naguirre/mds-builder/mds-hardware/README.md

# mds-hardware

KiCad sources and fabrication outputs for a small network audio player board built around an Allwinner F1C200s SoC, an ESP32-C3 for Wi-Fi, NAND flash storage, an EA3036 power management IC, and an audio DAC daughter board.

The repository contains two KiCad projects:
- [network_player/](network_player/) — the main board
- [dac/](dac/) — the audio DAC daughter board

## Versions

| Version | Date | Status | Schematic | PCB | Gerbers |
|---|---|---|---|-----|---|
| v1 | 2024-01-15 | Sent to JLCPCB, had routing issues | [PDF](../doc/static/hardware/v1/schematic.pdf) | [PDF](../doc/static/hardware/v1/pcb.pdf) | [ZIP](../doc/static/hardware/v1/gerbers.zip) |
| v1.1 | 2024-06-02 | Sent to JLCPCB, fixes routing issues of v1 | [PDF](../doc/static/hardware/v1.1/schematic.pdf) | [PDF](../doc/static/hardware/v1.1/pcb.pdf) | [ZIP](../doc/static/hardware/v1.1/gerbers.zip) |
| v2 | 2024-10-17 | Full redesign on Allwinner T113-s3, never produced | [PDF](../doc/static/hardware/v2/schematic.pdf) | [PDF](../doc/static/hardware/v2/pcb.pdf) | [ZIP](../doc/static/hardware/v2/gerbers.zip) |

See also the rendered [Board design](../doc/content/hardware/design.md) page in the main documentation.

References on GitHub: v1 is at commit [`c1560a5`](../../commit/c1560a5), v1.1 is the [`v1.1`](../../tree/v1.1) tag, v2 lives on the [`network_player_v2`](../../tree/network_player_v2) branch. The [`v1_jlcpcb`](../../tree/v1_jlcpcb) tag points to the JLCPCB return files for v1.

## Latest produced version: v1.1

v1.1 is the version that was actually fabricated and assembled by JLCPCB. Compared to v1, it brings the following changes (see commit [`47ae173`](../../commit/47ae173)):

- Removed the discrete transistors used for ESP32 boot/reset, driven directly from F1C200s GPIOs instead
- EA3036 enable pin tied to 3.3 V
- Added a RST button that pulls the MISO line to ground to disable booting from flash
- ESP32 moved to SPI1; SPI0 is now shared between the NAND flash and the RPi connector

### Schematic

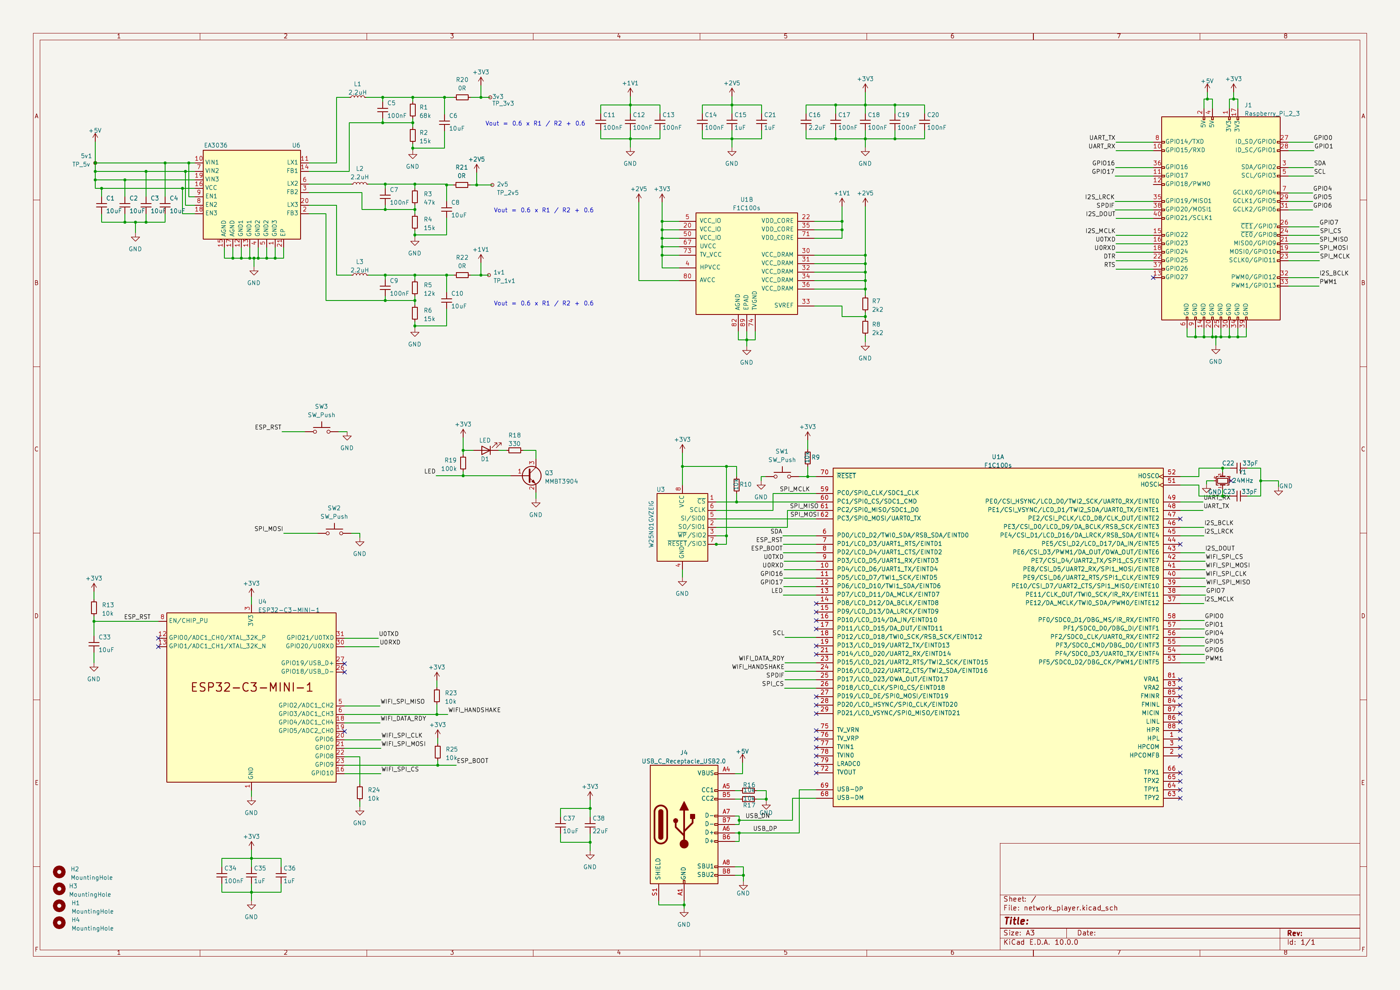
[picture p1: doc/static/hardware/v1.1/schematic.png]
v1.1 schematic


## License

The hardware design (KiCad sources, schematics, PCB layouts and gerbers) is released under the **CERN Open Hardware Licence Version 2 — Permissive** (CERN-OHL-P v2). See [LICENSE](LICENSE).

Copyright (c) 2026 Nicolas Aguirre.
