naguirre/mds-builder/doc/content/hardware/design.md

+++
title = "Board design"
description = "KiCad sources, schematics, PCB versions and fabrication outputs"
weight = 3
+++

# Board design

The board has been designed with [KiCad](https://www.kicad.org/). Both KiCad 7.x and 8.x have been used during the development.

The KiCad sources live in this repository under `mds-hardware/`, split into two projects:

- `mds-hardware/network_player/` — the main board
- `mds-hardware/dac/` — the audio DAC daughter board

## Schematics

A rendered SVG of the schematics is included for quick reference:

{{ img(path="images/network_player.svg", alt="Schematics") }}

## Versions

<table>
  <thead>
    <tr><th>Version</th><th>Date</th><th>Status</th><th>Schematic</th><th>PCB</th><th>Gerbers</th></tr>
  </thead>
  <tbody>
    <tr>
      <td>v1</td><td>2024-01-15</td><td>Sent to JLCPCB, had routing issues</td>
      <td>{{ dl(path="hardware/v1/schematic.pdf", text="PDF") }}</td>
      <td>{{ dl(path="hardware/v1/pcb.pdf", text="PDF") }}</td>
      <td>{{ dl(path="hardware/v1/gerbers.zip", text="ZIP") }}</td>
    </tr>
    <tr>
      <td>v1.1</td><td>2024-06-02</td><td>Sent to JLCPCB, fixes routing issues of v1</td>
      <td>{{ dl(path="hardware/v1.1/schematic.pdf", text="PDF") }}</td>
      <td>{{ dl(path="hardware/v1.1/pcb.pdf", text="PDF") }}</td>
      <td>{{ dl(path="hardware/v1.1/gerbers.zip", text="ZIP") }}</td>
    </tr>
    <tr>
      <td>v2</td><td>2024-10-17</td><td>Full redesign on Allwinner T113-s3, never produced</td>
      <td>{{ dl(path="hardware/v2/schematic.pdf", text="PDF") }}</td>
      <td>{{ dl(path="hardware/v2/pcb.pdf", text="PDF") }}</td>
      <td>{{ dl(path="hardware/v2/gerbers.zip", text="ZIP") }}</td>
    </tr>
  </tbody>
</table>

## Latest produced version: v1.1

v1.1 is the version that was actually fabricated and assembled by JLCPCB. Compared to v1, it brings the following changes:

- Removed the discrete transistors used for ESP32 boot/reset, driven directly from F1C200s GPIOs instead
- EA3036 enable pin tied to 3.3 V
- Added a RST button that pulls the MISO line to ground to disable booting from flash
- ESP32 moved to SPI1; SPI0 is now shared between the NAND flash and the RPi connector

{{ img(path="hardware/v1.1/schematic.png", alt="v1.1 schematic") }}

### Assembled boards

The v1.1 board as assembled by JLCPCB:

{{ img(path="images/v1.1_top.jpeg", alt="Network player v1.1, top side") }}

{{ img(path="images/v1.1_bottom.jpeg", alt="Network player v1.1, bottom side") }}

For reference, the earlier v1 board:

{{ img(path="images/v1.0_top.jpeg", alt="Network player v1, top side") }}

{{ img(path="images/v1.0_bottom.jpeg", alt="Network player v1, bottom side") }}
