naguirre/mds-builder/doc/content/development/_index.md

+++
title = "Development"
description = "Day-to-day development tasks on the firmware"
sort_by = "weight"
weight = 5
template = "section.html"
page_template = "page.html"
+++

# Development

This section collects the things you reach for during normal development cycles: rebuilding the kernel or U-Boot, pushing a new module to the running board, debugging over serial.

## Sections

- [Kernel development](@/development/kernel.md) — iterate on Linux + custom drivers
- [U-Boot development](@/development/uboot.md) — iterate on the bootloader and DTS
- [Debugging](@/development/debugging.md) — console access, USB gadget, common issues
- [ESP-Hosted firmware](@/development/esp-hosted.md) — rebuild the ESP32-C3 firmware and bring up the Wi-Fi link
