naguirre/mds-builder/mds-hardware/network_player/network_player.pdf

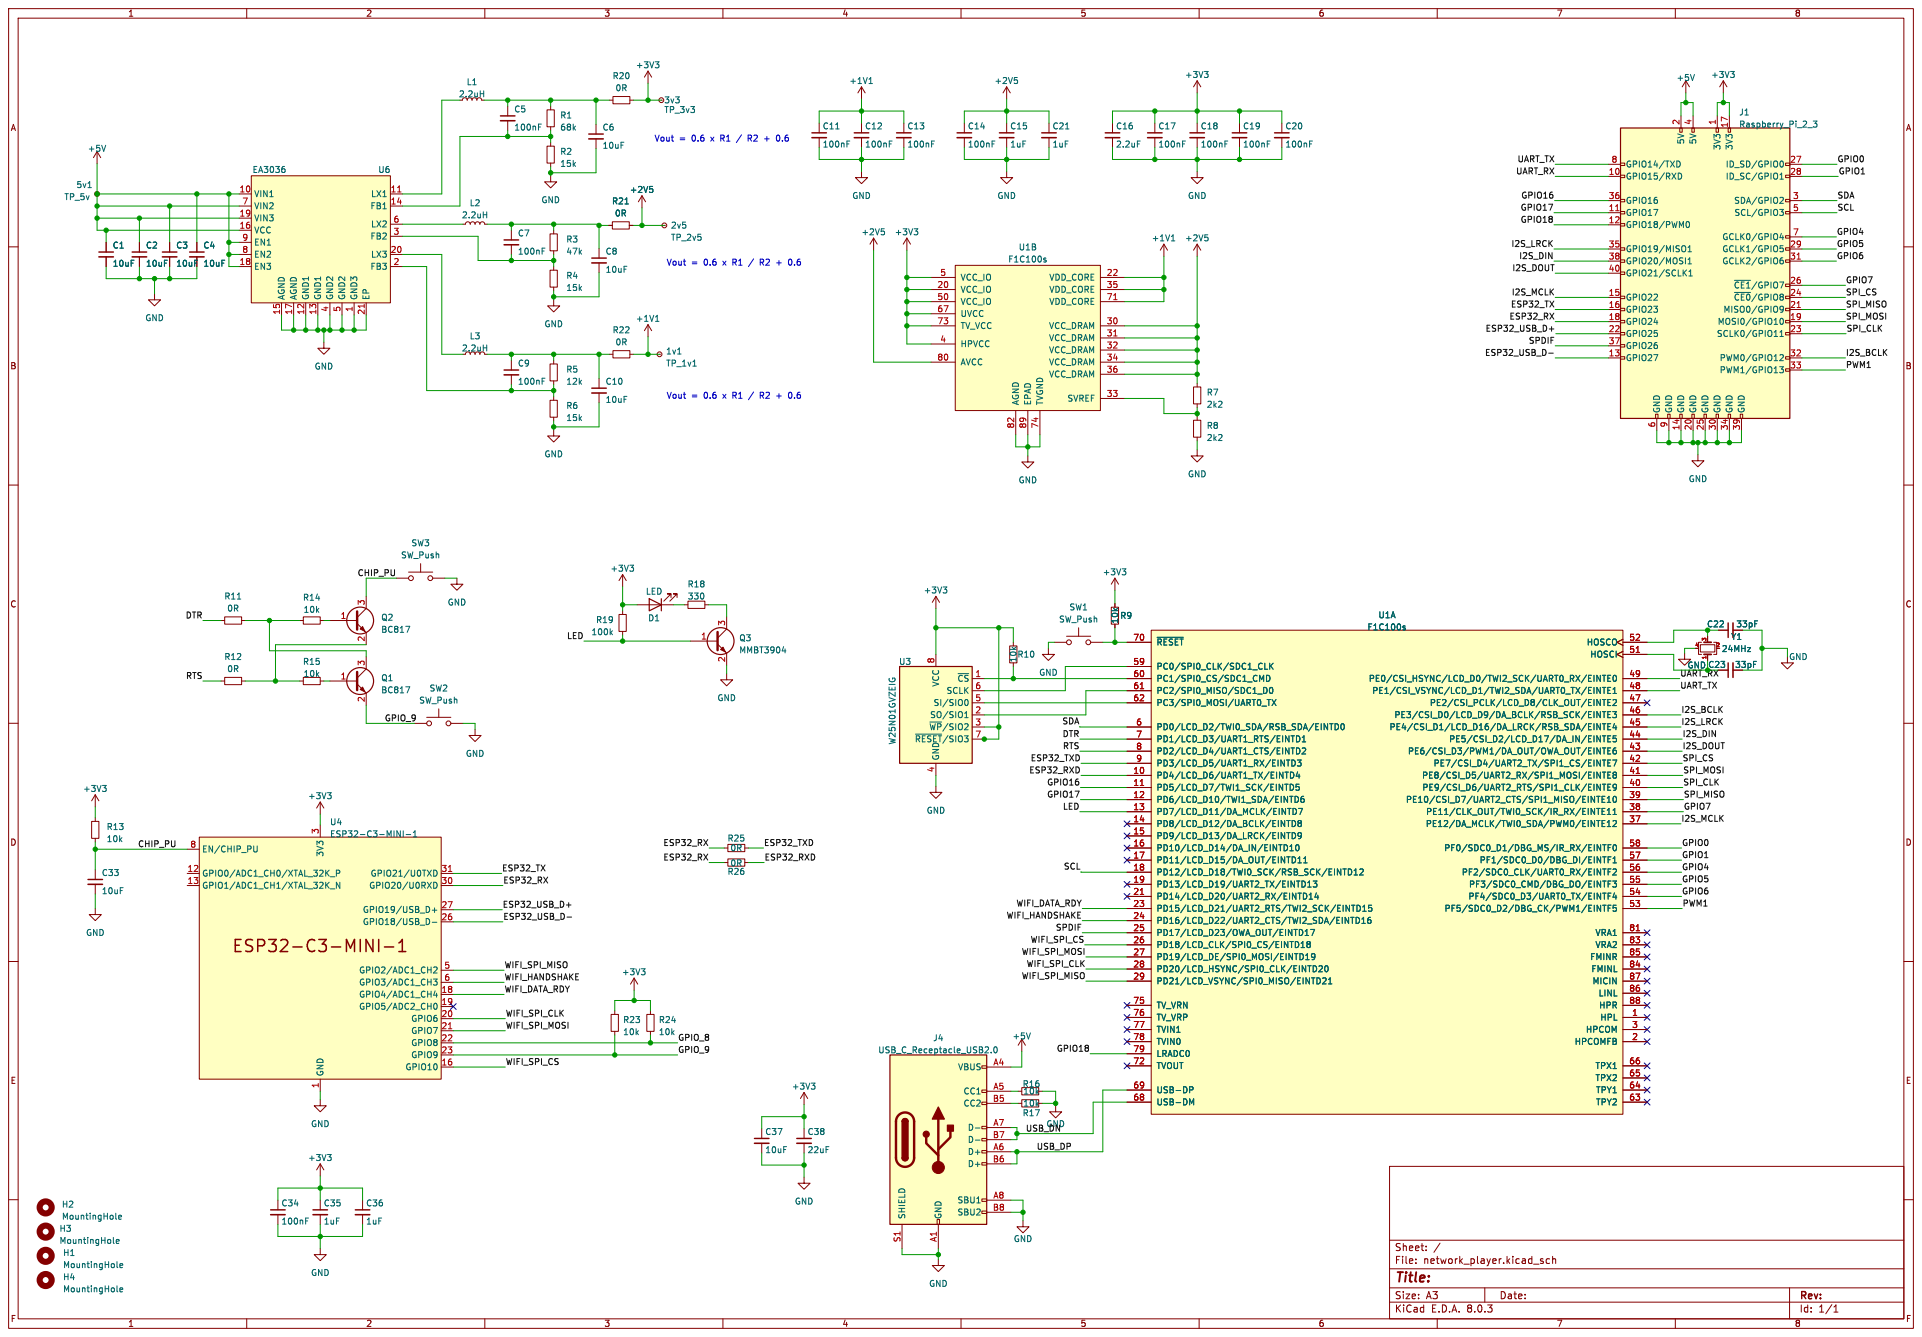
[picture p2: page 1]

4 SI/SIO0 5 SCLK 6 ~{RESET}/SIO37 VCC
~{CS}1 SO/SIO1 2 ~{WP}/SIO23 GND

3 GPIO20/U0RXD 30 GPIO21/U0TXD 31 GPIO2/ADC1_CH2 5 GPIO3/ADC1_CH3 6 EN/CHIP_PU 8 U4ESP32-C3-MINI-1 GND GND

Id: 1/1 Title: File: network_player.kicad_sch Sheet: /
