naguirre/mds-builder/doc/static/hardware/v2/schematic.pdf

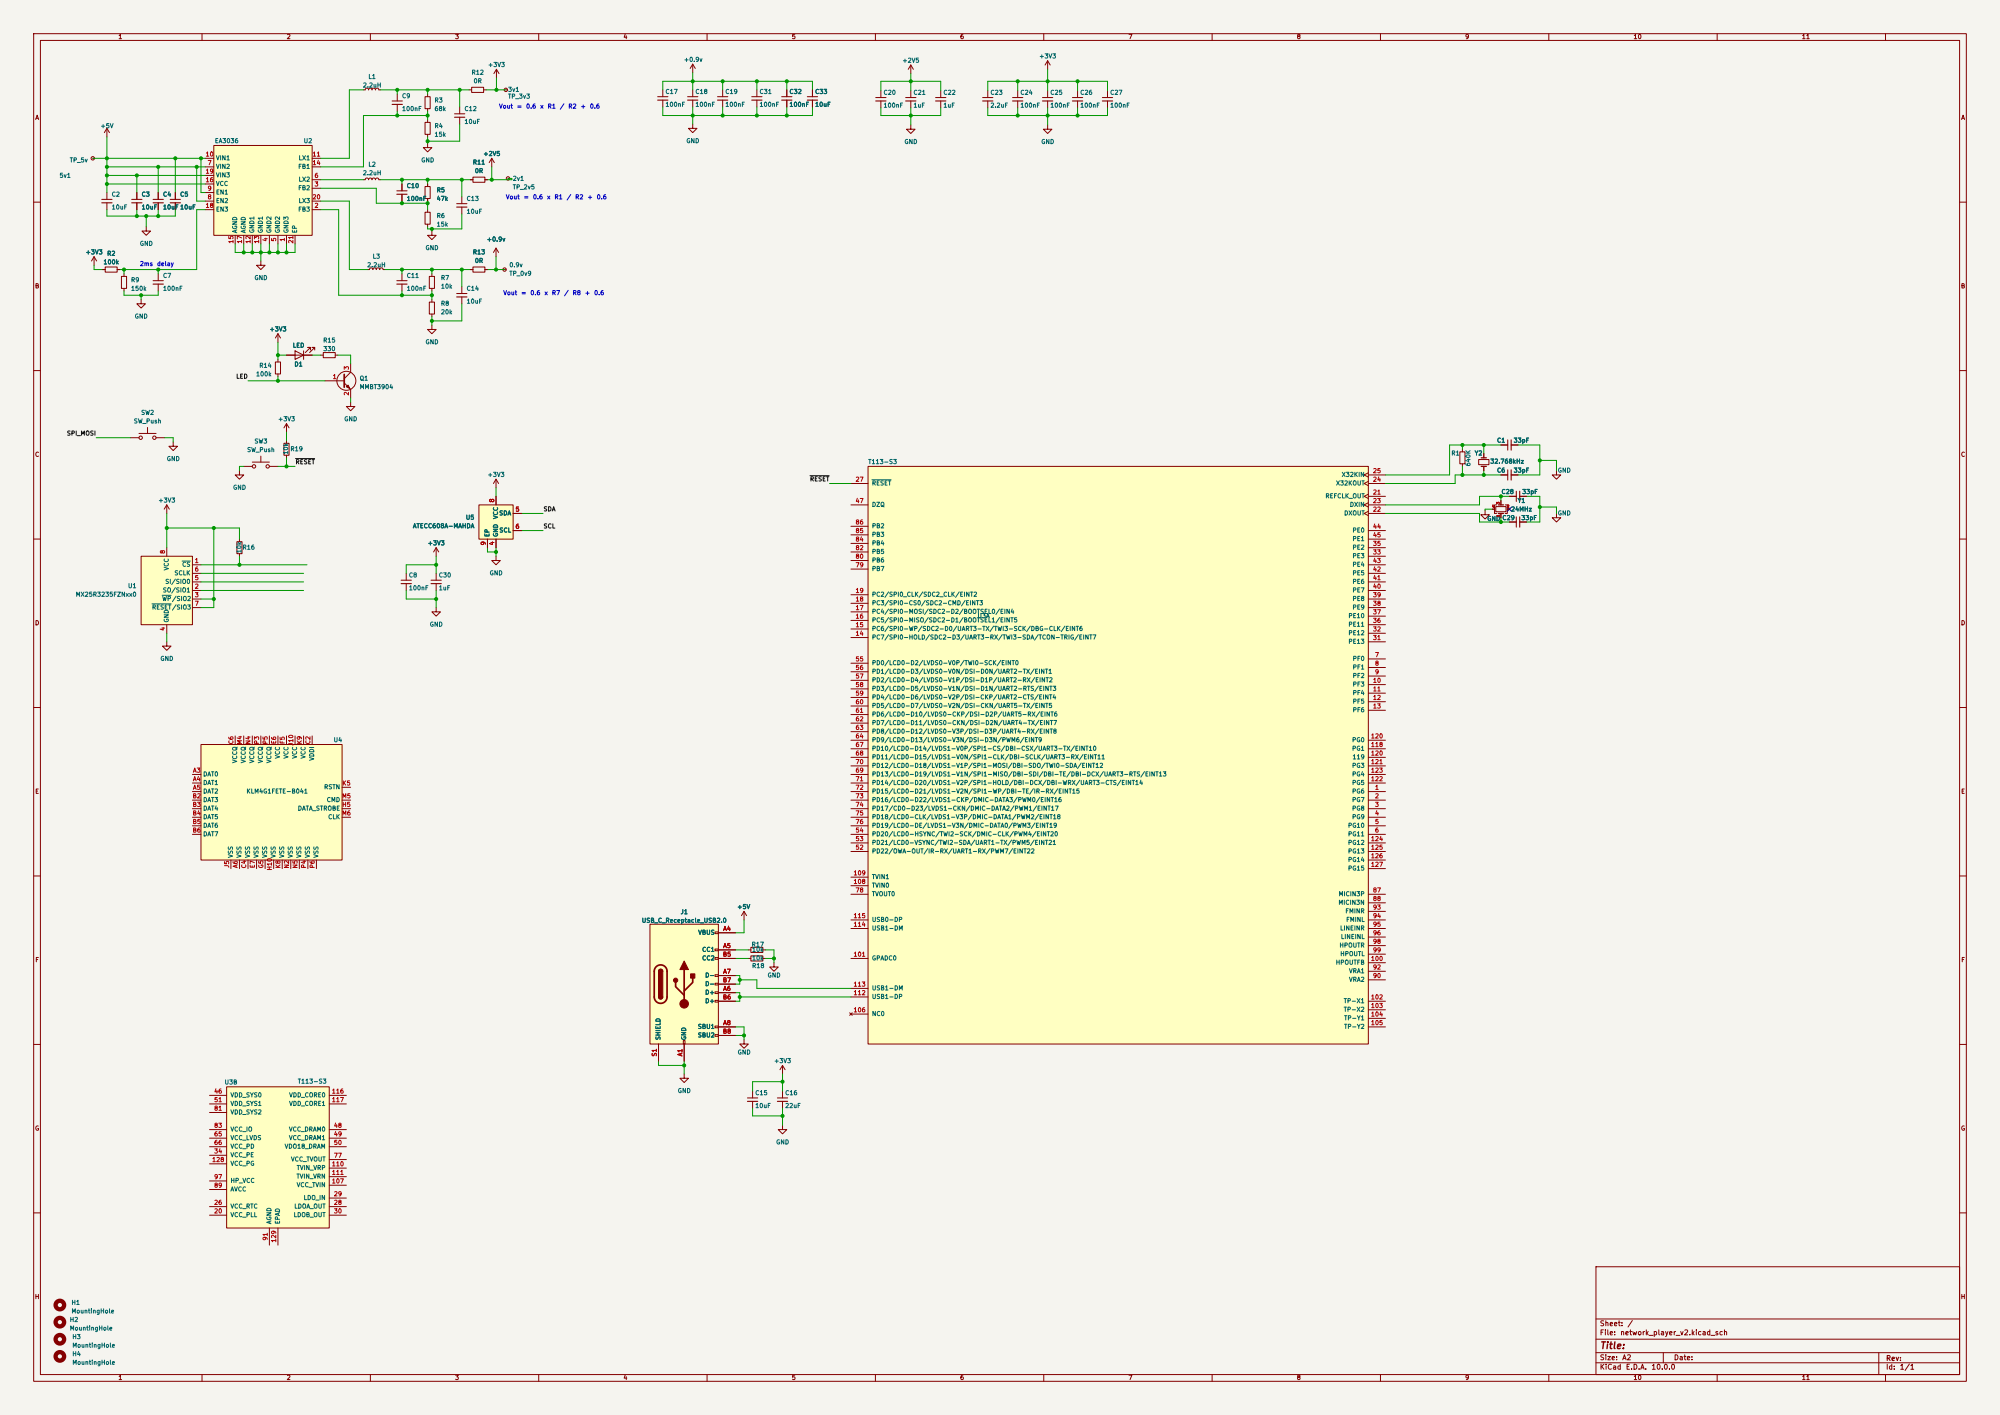
[picture p3: page 1]

Size: A2 | Rev:
KiCad E.D.A. 10.0.0 | Id: 1/1
