naguirre/mds-builder/doc/static/hardware/v2/pcb.pdf

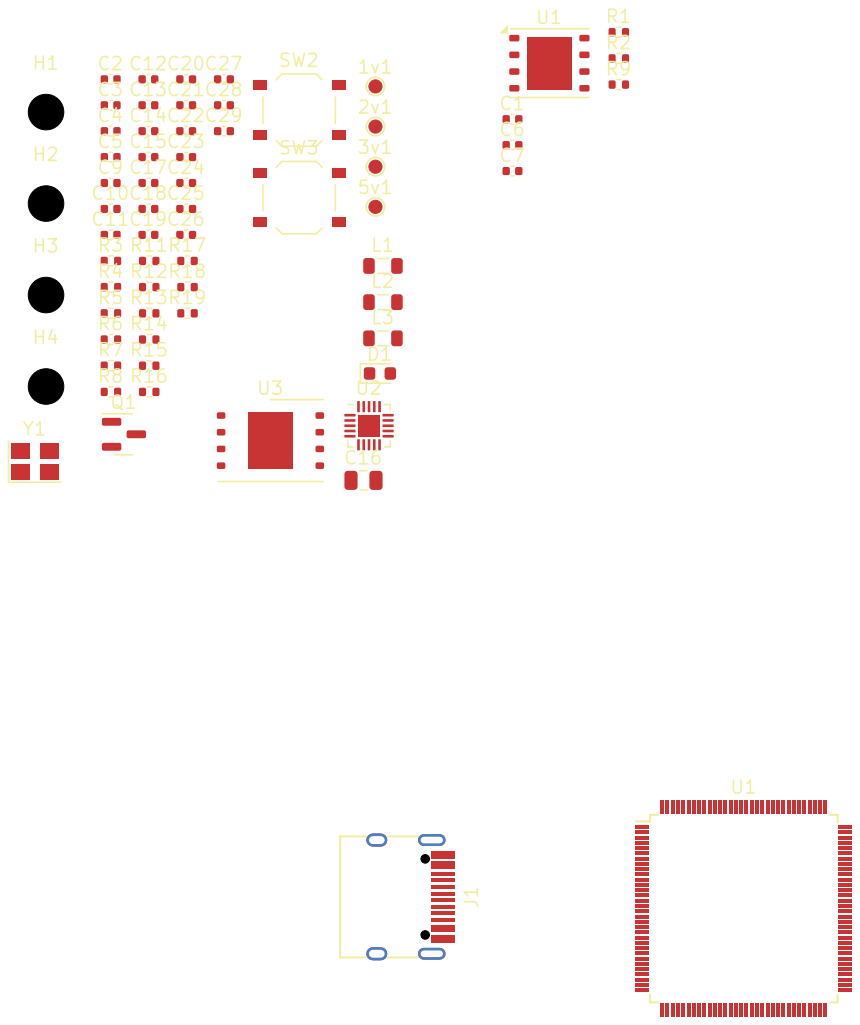
[picture p4: page 1]
