naguirre/mds-builder/doc/static/hardware/v1.1/schematic.pdf

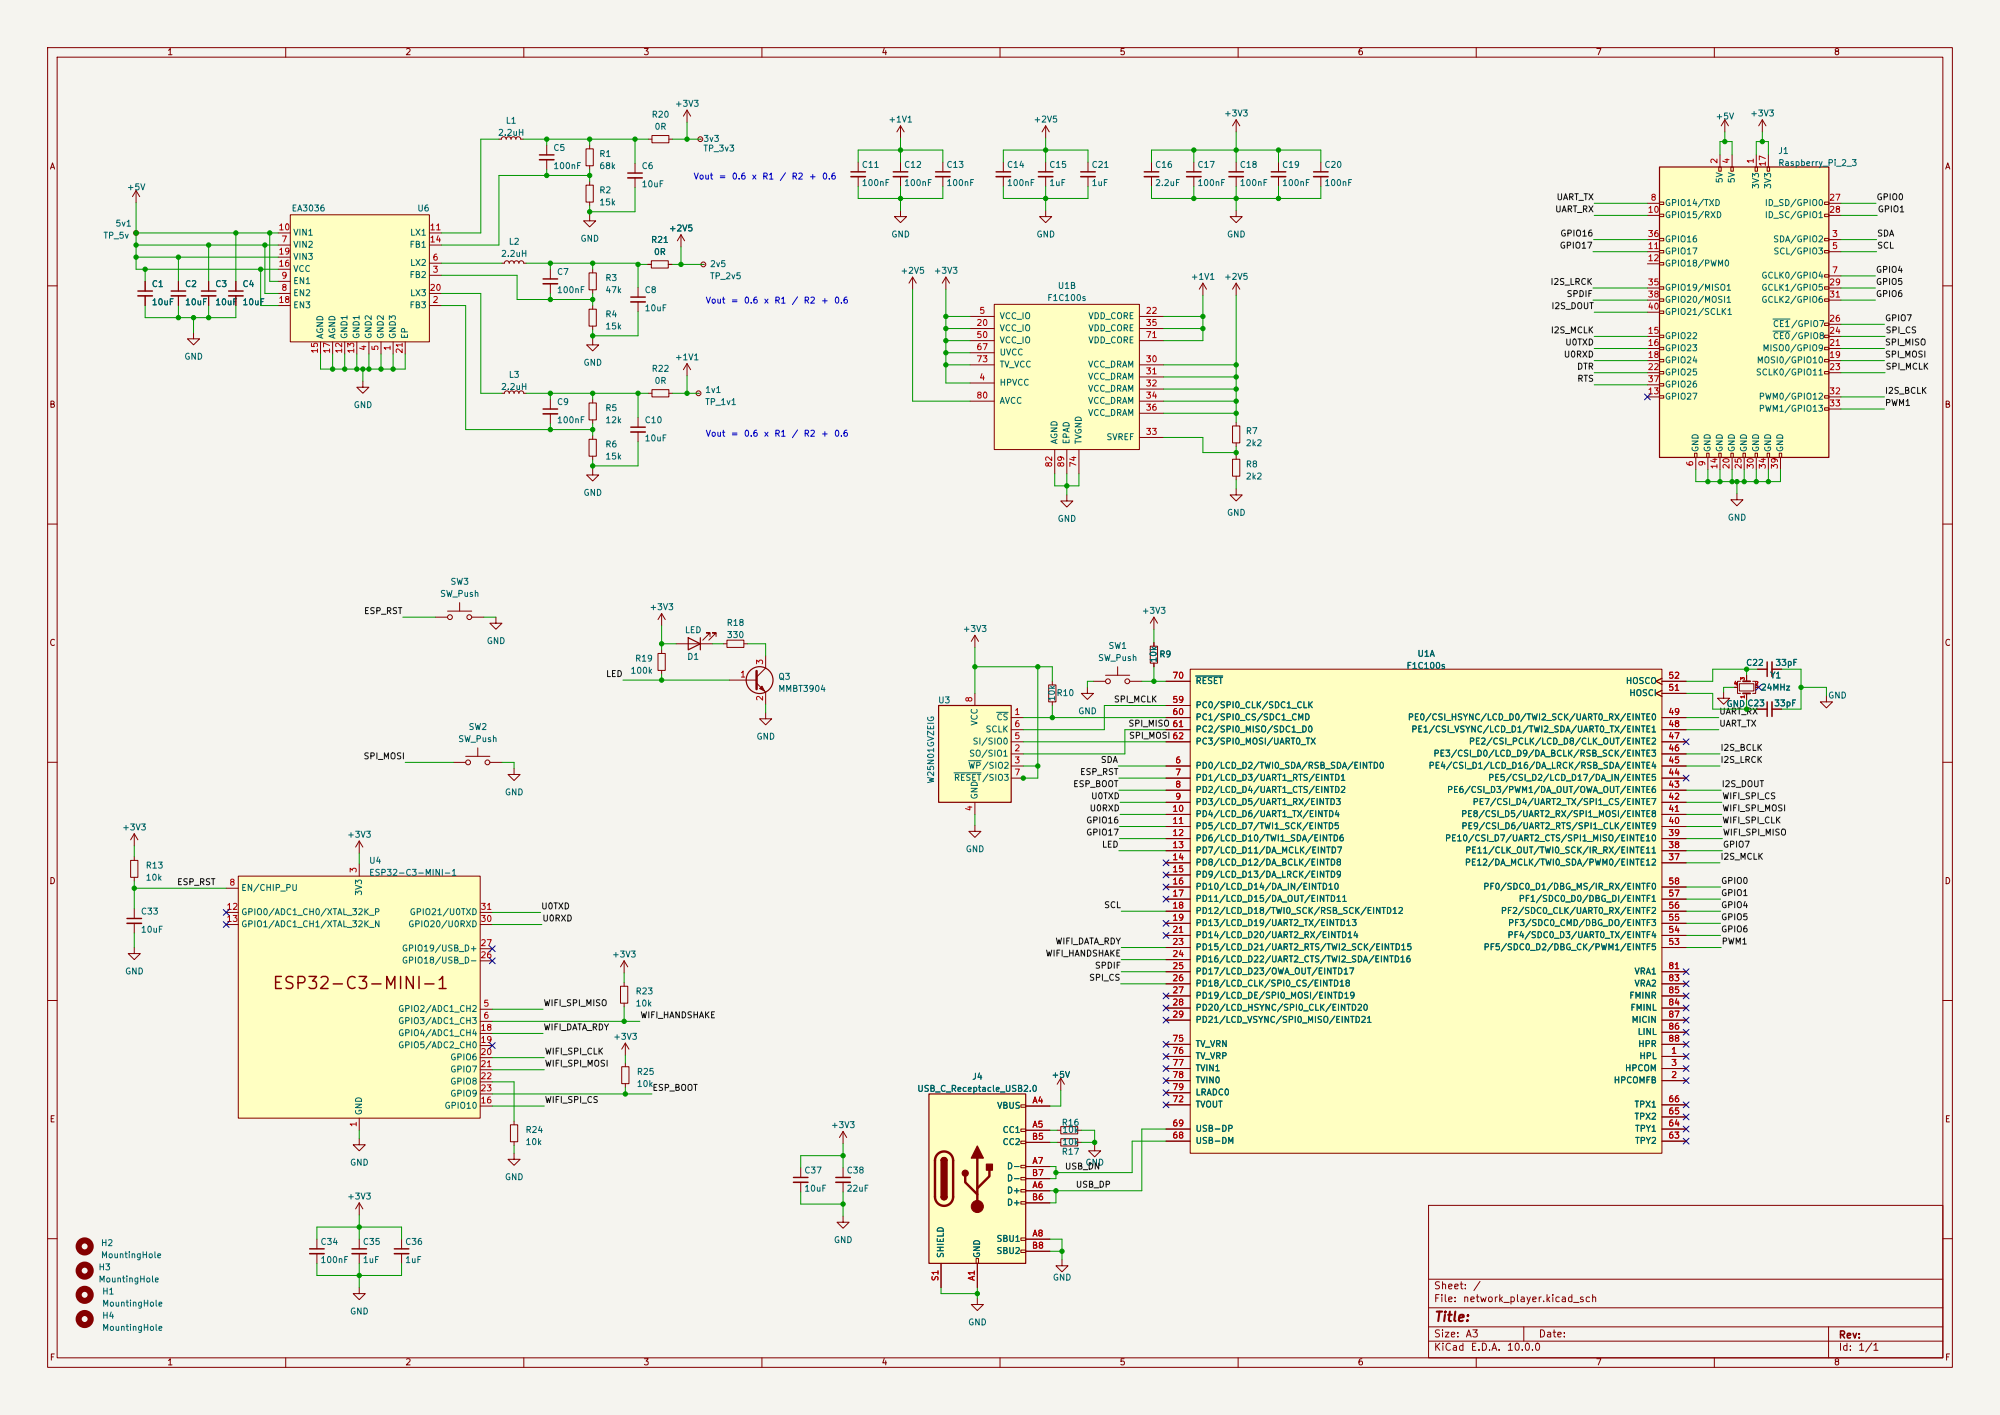
[picture p5: page 1]

VIN2 7
VIN3 19

Size: A3 | Rev: | F Date:
KiCad E.D.A. 10.0.0 | Id: 1/1
