naguirre/mds-builder/doc/static/hardware/v1.1/pcb.pdf

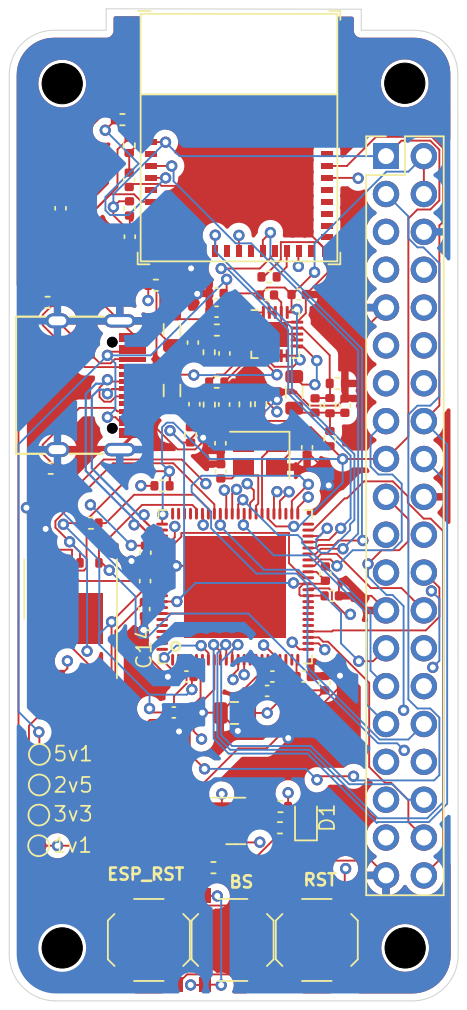
[picture p6: page 1]
