naguirre/mds-builder/doc/static/hardware/v1/pcb.pdf

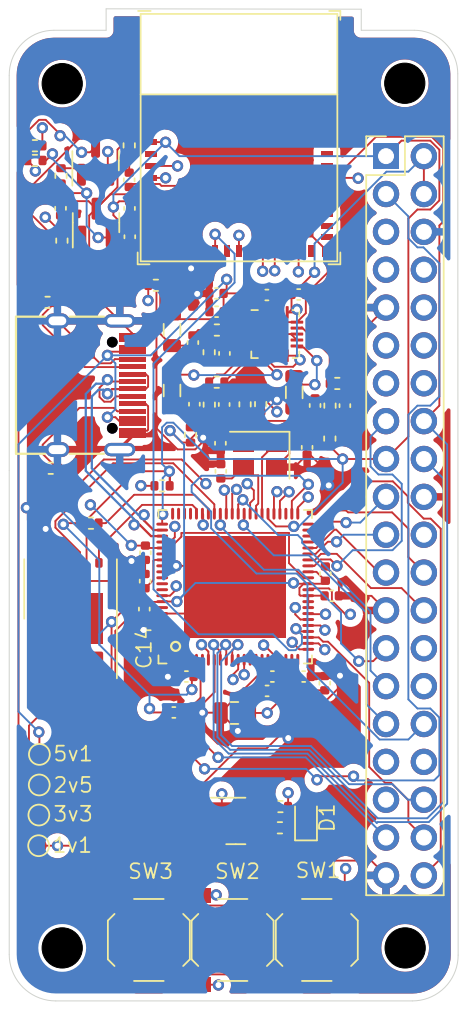
[picture p7: page 1]
