naguirre/mds-builder/mds-hardware/dac/dac.kicad_pcb

## KiCad design mds-hardware/dac/dac.kicad_pcb (2026-05-27)

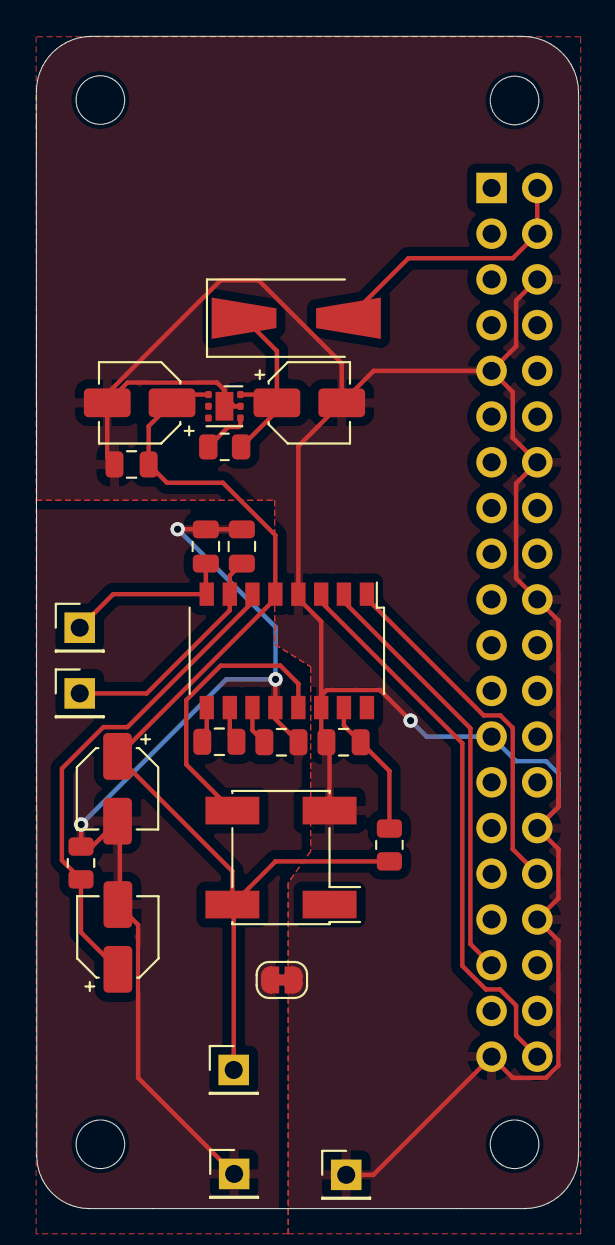
[picture p8: board dac.kicad_pcb from above]

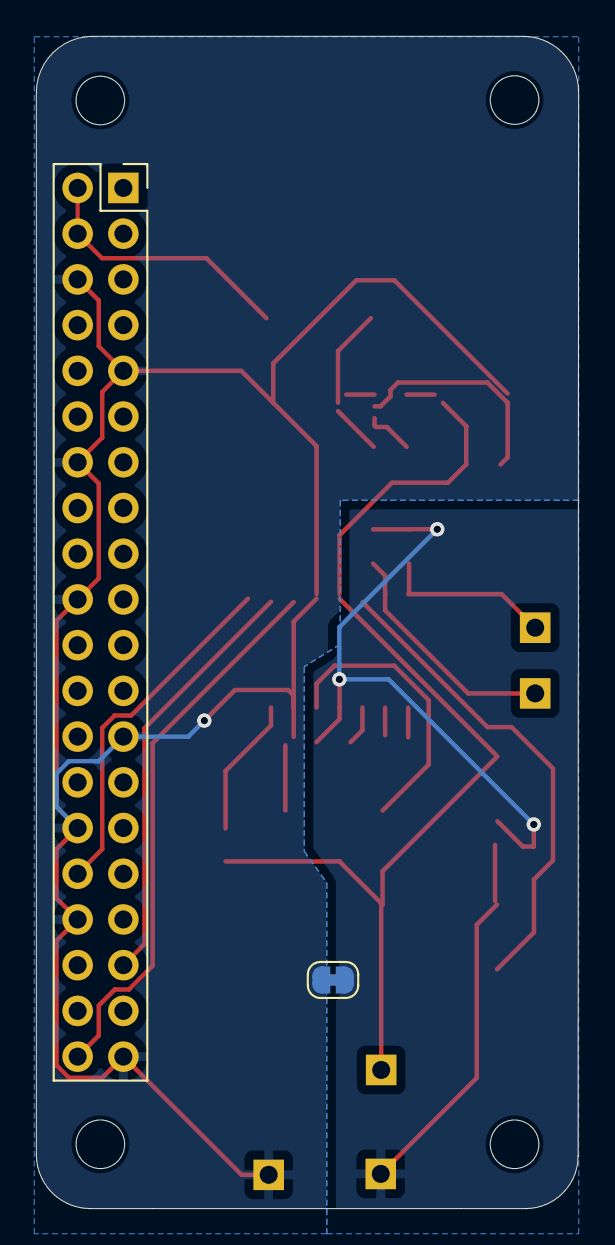
[picture p9: board dac.kicad_pcb from below]

Board: 2 copper layers, 30.1 x 65.1 mm, 29 parts (2 on the bottom side), 17 nets.

Parts:
C1: 2.2uF; C_0805_2012Metric
C2: 2.2uF/50V; CP_Elec_4x5.8
C3, C8, C9: 10uF/25V; CP_Elec_4x5.8
C4, C5, C10: 1uF; C_0805_2012Metric
C6, C7: 4.7nF; C_0805_2012Metric
D1: 1N5822/SS34/SMA; D_SMA-SMB_Universal_Handsoldering
H1, H2, H3, H4: MountingHole; MountingHole_2.7mm_M2.5
J1: Raspberry_Pi_2_3; PinSocket_2x20_P2.54mm_Vertical
J2: LEFT; PinHeader_1x01_P2.54mm_Vertical
J3: RIGHT; PinHeader_1x01_P2.54mm_Vertical
J6: 3v3; PinHeader_1x01_P2.54mm_Vertical
J7: GND; PinHeader_1x01_P2.54mm_Vertical
J8: GNDA; PinHeader_1x01_P2.54mm_Vertical
NT1, NT2: NetTie_2; SolderJumper-2_P1.3mm_Bridged_RoundedPad1.0x1.5mm
R1, R3: 100k; R_0805_2012Metric
R2: 220k; R_0805_2012Metric
U1: TCXO 49.152 MHz; Oscillator_SMD_Fordahl_DFAS11-4Pin_7.0x5.0mm_HandSoldering
U2: ES9023; SOP-16_4.4x10.4mm_P1.27mm
U5: LP5912-3.3DRV; WSON-6-1EP_2x2mm_P0.65mm_EP1x1.6mm

Connections:
+3V3: C2.1, C9.1, C10.1, J6.1, R1.2, U1.4 (VDD), U2.5 (AVCC), U5.1 (OUT)
+5V: D1.2 (A), J1.2 (5V), J1.4 (5V)
/AUDIO_LEFT: C7.1, J2.1, U2.7 (AOUTL)
/AUDIO_RIGHT: C6.1, J3.1, U2.8 (AOUTR)
/I2S_BCLK: J1.32 (PWM0/GPIO12), U2.1 (BCK)
/I2S_DOUT: J1.40 (GPIO21/SCLK1), U2.3 (SDI)
/I2S_LRCK: J1.35 (GPIO19/MISO1), U2.2 (LRCK)
/VIN: C8.1, D1.1 (K), R3.2, U5.6 (IN)
GND: C1.2, C8.2, C9.2, C10.2, J1.6 (GND), J1.9 (GND), J1.14 (GND), J1.20 (GND), J1.25 (GND), J1.30 (GND), J1.34 (GND), J1.39 (GND), J7.1, NT1.1, NT2.1, U1.2 (GND), U2.4 (DIF), U2.14 (DGND), U5.5 (GND), U5.7 (EP)
GNDA: C2.2, C3.2, C4.2, C6.2, C7.2, J8.1, NT1.2, NT2.2, R2.1, U2.12 (AGND)
unnamed: U1.3 (OUT), U2.13 (MCLK)
unnamed: C5.2, U2.10 (CN)
unnamed: C5.1, U2.9 (CP)
unnamed: C1.1, R1.1, U2.15 (MUTE_B)
unnamed: C4.1, U2.11 (NEG)
unnamed: C3.1, R2.2, U2.6 (VREG)
unnamed: R3.1, U5.4 (EN)
