naguirre/mds-builder/mds-hardware/network_player/network_player.kicad_pcb

## KiCad design mds-hardware/network_player/network_player.kicad_pcb (2026-05-27)

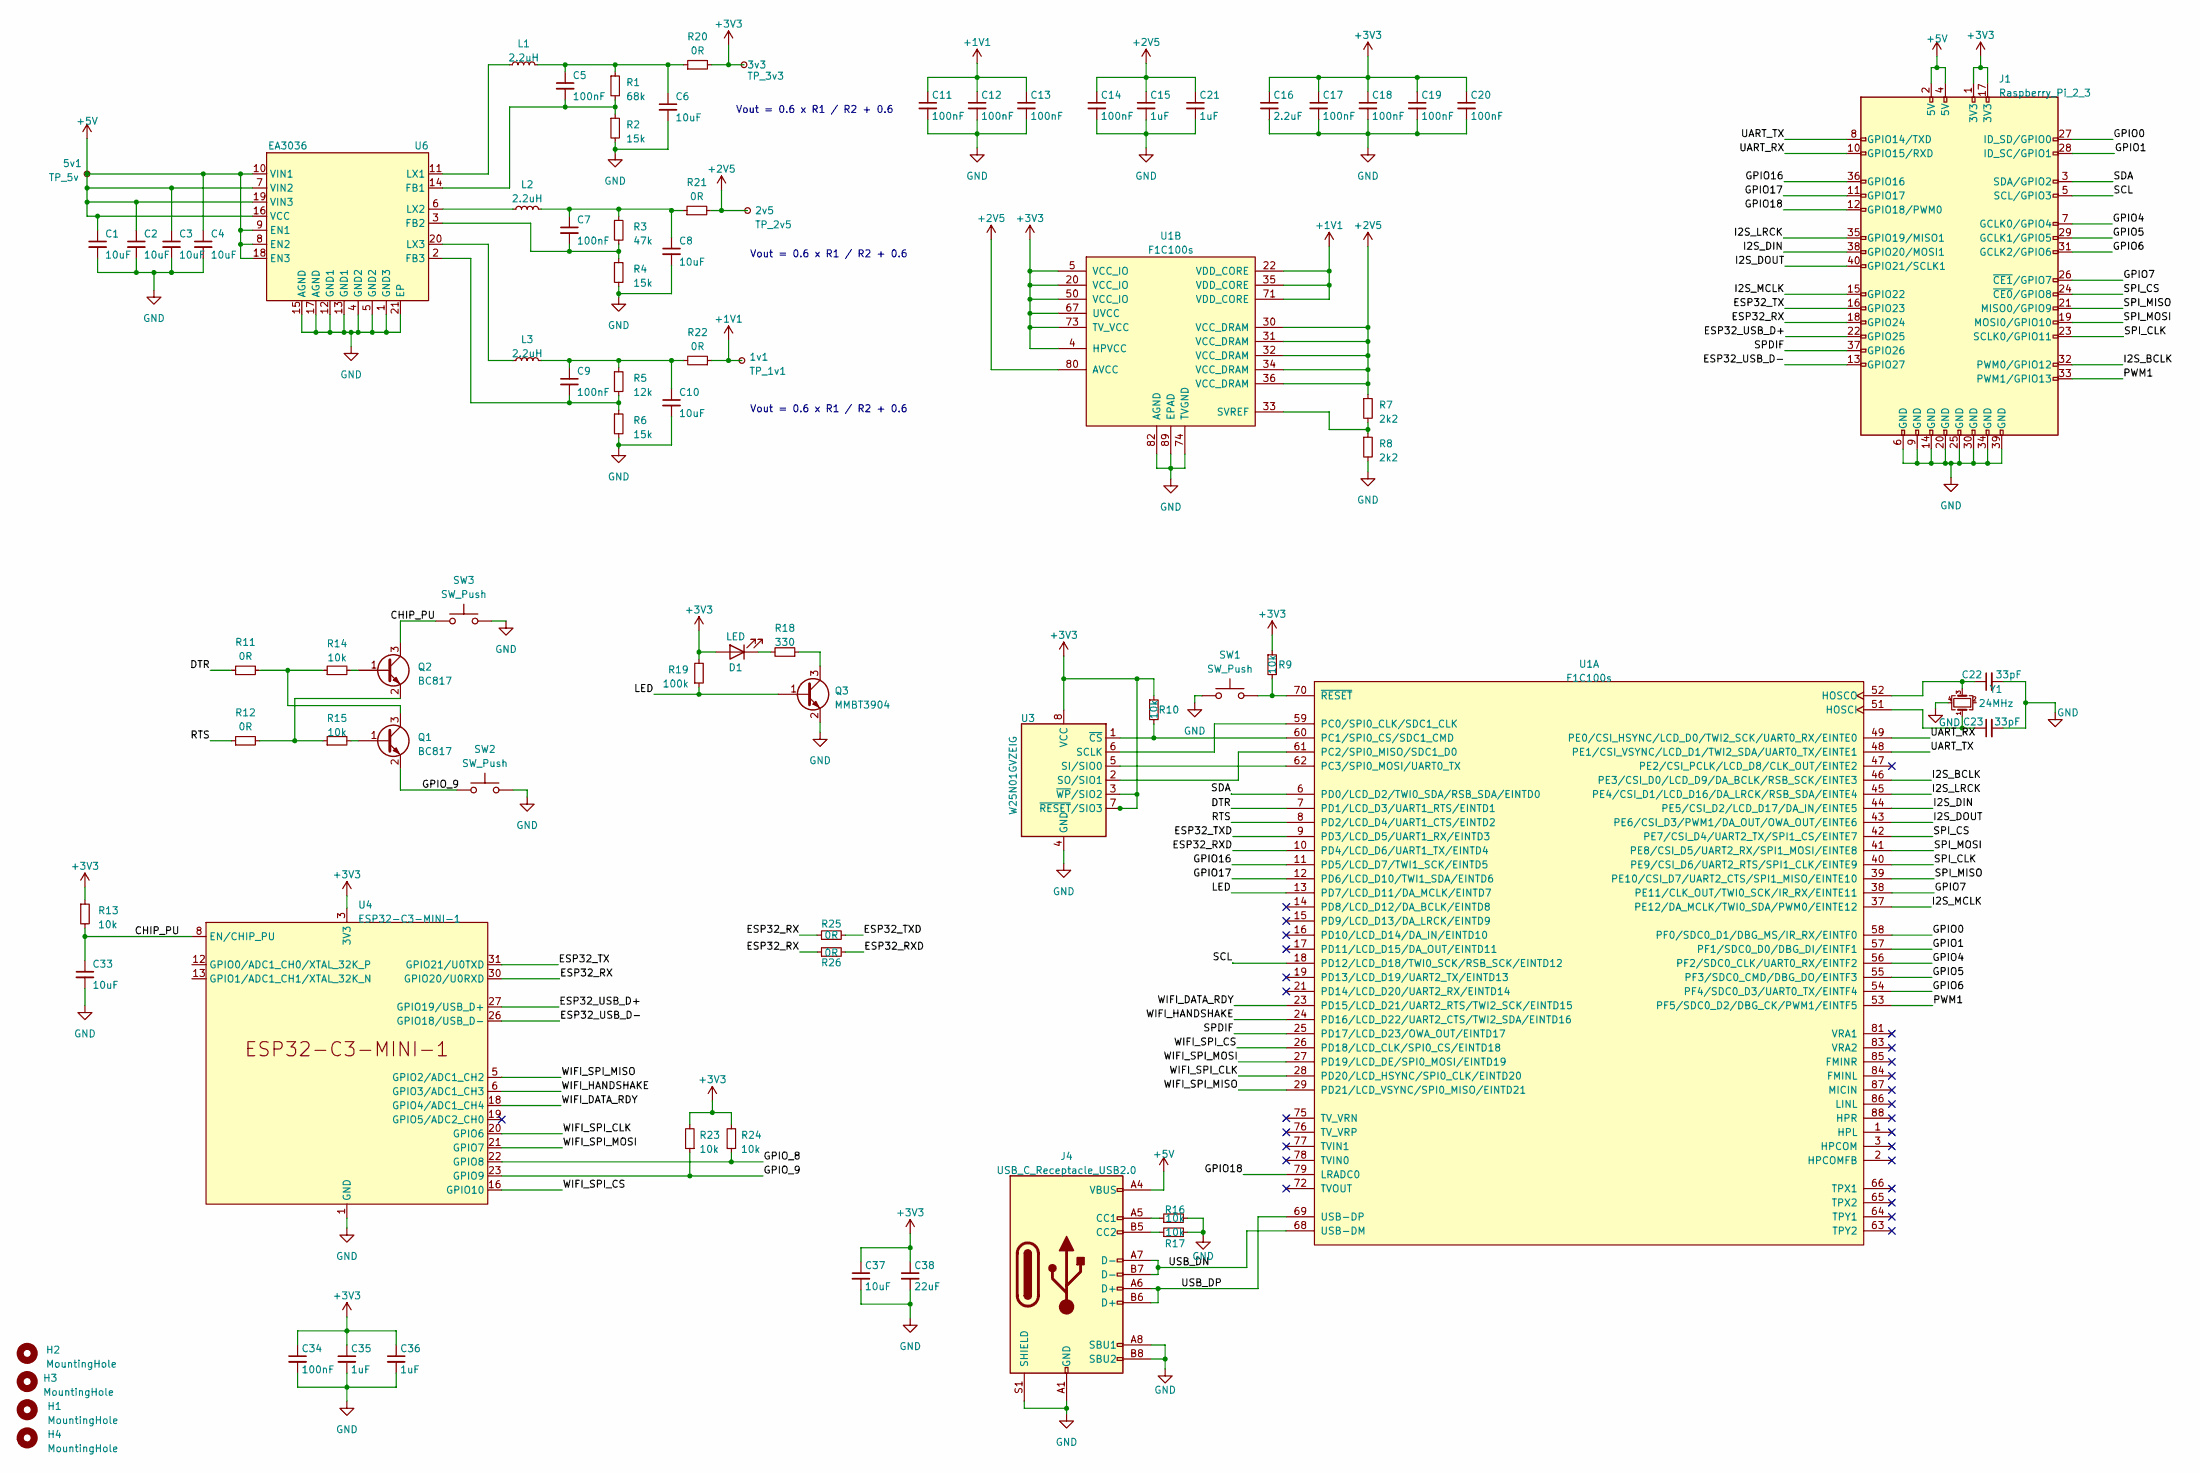
[picture p10: schematic network_player.kicad_sch]

Parts:
1v1: TP_1v1; TestPoint_Pad_D1.0mm
2v5: TP_2v5; TestPoint_Pad_D1.0mm
3v3: TP_3v3; TestPoint_Pad_D1.0mm
5v1: TP_5v; TestPoint_Pad_D1.0mm
C1, C2, C3, C4, C6, C8, C10, C33, C37: 10uF; C_0402_1005Metric; LCSC C15525
C5, C7, C9, C11, C12, C13, C14, C17, C18, C19, C20, C34: 100nF; C_0402_1005Metric; LCSC C307331
C15, C21, C35, C36: 1uF; C_0402_1005Metric; LCSC C52923
C16: 2.2uF; C_0402_1005Metric; LCSC C12530
C22, C23: 33pF; C_0402_1005Metric; LCSC C1562
C38: 22uF; C_0805_2012Metric; LCSC C59461
D1: LED; LED_0603_1608Metric
H1, H2, H3, H4: MountingHole; MountingHole_2.7mm_M2.5
J1: Raspberry_Pi_2_3; PinHeader_2x20_P2.54mm_Vertical
J4: USB_C_Receptacle_USB2.0; USB_C_Receptacle_GT-USB-7010; LCSC C963370
L1, L2, L3: 2.2uH; L_0805_2012Metric; LCSC C1043
Q1, Q2: BC817; SOT-23; LCSC C2150
Q3: MMBT3904; SOT-23; LCSC C20526
R1: 68k; R_0402_1005Metric; LCSC C36871
R2, R4, R6: 15k; R_0402_1005Metric; LCSC C25756
R3: 47k; R_0402_1005Metric; LCSC C25792
R5: 12k; R_0402_1005Metric; LCSC C25752
R7, R8: 2k2; R_0402_1005Metric; LCSC C25879
R9, R10, R13, R14, R15, R16, R17, R23, R24: 10k; R_0402_1005Metric; LCSC C25744
R11, R12, R20, R21, R22, R25, R26: 0R; R_0402_1005Metric; LCSC C17168
R18: 330; R_0402_1005Metric; LCSC C25104
R19: 100k; R_0402_1005Metric; LCSC C25741
SW1, SW2, SW3: SW_Push; SW_Push_1P1T_XKB_TS-1187A; LCSC C318884
U1: F1C100s; QFN-88_EP_10x10_Pitch0.4mm; LCSC C2879851
U3: W25N01GVZEIG; WSON-8-1EP_8x6mm_P1.27mm_EP3.4x4.3mm; LCSC C88868
U4: ESP32-C3-MINI-1; LCSC C2838502
U6: EA3036; QFN-20-1EP_3x3mm_P0.4mm_EP1.65x1.65mm; LCSC C570857
Y1: 24MHz; Crystal_SMD_SeikoEpson_TSX3225-4Pin_3.2x2.5mm; LCSC C15643

Connections:
+1V1: 1v1.1, C11.1, C12.1, C13.1, R22.1, U1.22 (VDD_CORE), U1.35 (VDD_CORE), U1.71 (VDD_CORE)
+2V5: 2v5.1, C14.1, C15.1, C21.1, R7.1, R21.2, U1.30 (VCC_DRAM), U1.31 (VCC_DRAM), U1.32 (VCC_DRAM), U1.34 (VCC_DRAM), U1.36 (VCC_DRAM), U1.80 (AVCC)
+3V3: 3v3.1, C16.1, C17.1, C18.1, C19.1, C20.1, C34.1, C35.1, C36.1, C37.1, C38.1, D1.2 (A), J1.1 (3V3), J1.17 (3V3), R9.1, R10.1, R13.1, R19.2, R20.2, R23.2, R24.2, U1.4 (HPVCC), U1.5 (VCC_IO), U1.20 (VCC_IO), U1.50 (VCC_IO), U1.67 (UVCC), U1.73 (TV_VCC), U3.3 (~WP/SIO2), U3.7 (~RESET/SIO3), U3.8 (VCC), U4.3 (3V3)
+5V: 5v1.1, C1.1, C2.1, C3.1, C4.1, J1.2 (5V), J1.4 (5V), J4.A4 (VBUS), J4.A9 (VBUS), J4.B4 (VBUS), J4.B9 (VBUS), U6.7 (VIN2), U6.8 (EN2), U6.9 (EN1), U6.10 (VIN1), U6.16 (VCC), U6.18 (EN3), U6.19 (VIN3)
/CHIP_PU: C33.1, Q2.3 (C), R13.2, SW3.1, U4.8 (EN/CHIP_PU)
/DTR: R11.1, U1.7 (PD1/LCD_D3/UART1_RTS/EINTD1)
/ESP32_RX: J1.18 (GPIO24), R25.1, R26.1, U4.30 (GPIO20/U0RXD)
/ESP32_RXD: R26.2, U1.10 (PD4/LCD_D6/UART1_TX/EINTD4)
/ESP32_TX: J1.16 (GPIO23), U4.31 (GPIO21/U0TXD)
/ESP32_TXD: R25.2, U1.9 (PD3/LCD_D5/UART1_RX/EINTD3)
/ESP32_USB_D+: J1.22 (GPIO25), U4.27 (GPIO19/USB_D+)
/ESP32_USB_D-: J1.13 (GPIO27), U4.26 (GPIO18/USB_D-)
/GPIO0: J1.27 (ID_SD/GPIO0), U1.58 (PF0/SDC0_D1/DBG_MS/IR_RX/EINTF0)
/GPIO1: J1.28 (ID_SC/GPIO1), U1.57 (PF1/SDC0_D0/DBG_DI/EINTF1)
/GPIO4: J1.7 (GCLK0/GPIO4), U1.56 (PF2/SDC0_CLK/UART0_RX/EINTF2)
/GPIO5: J1.29 (GCLK1/GPIO5), U1.55 (PF3/SDC0_CMD/DBG_DO/EINTF3)
/GPIO6: J1.31 (GCLK2/GPIO6), U1.54 (PF4/SDC0_D3/UART0_TX/EINTF4)
/GPIO7: J1.26 (~CE1/GPIO7), U1.38 (PE11/CLK_OUT/TWI0_SCK/IR_RX/EINTE11)
/GPIO16: J1.36 (GPIO16), U1.11 (PD5/LCD_D7/TWI1_SCK/EINTD5)
/GPIO17: J1.11 (GPIO17), U1.12 (PD6/LCD_D10/TWI1_SDA/EINTD6)
/GPIO18: J1.12 (GPIO18/PWM0), U1.79 (LRADC0)
/GPIO_8: R24.1, U4.22 (GPIO8)
/GPIO_9: Q1.2 (E), R23.1, SW2.1, U4.23 (GPIO9)
/I2S_BCLK: J1.32 (PWM0/GPIO12), U1.46 (PE3/CSI_D0/LCD_D9/DA_BCLK/RSB_SCK/EINTE3)
/I2S_DIN: J1.38 (GPIO20/MOSI1), U1.44 (PE5/CSI_D2/LCD_D17/DA_IN/EINTE5)
/I2S_DOUT: J1.40 (GPIO21/SCLK1), U1.43 (PE6/CSI_D3/PWM1/DA_OUT/OWA_OUT/EINTE6)
/I2S_LRCK: J1.35 (GPIO19/MISO1), U1.45 (PE4/CSI_D1/LCD_D16/DA_LRCK/RSB_SDA/EINT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)
/I2S_MCLK: J1.15 (GPIO22), U1.37 (PE12/DA_MCLK/TWI0_SDA/PWM0/EINTE12)
/LED: Q3.1 (B), R19.1, U1.13 (PD7/LCD_D11/DA_MCLK/EINTD7)
/PWM1: J1.33 (PWM1/GPIO13), U1.53 (PF5/SDC0_D2/DBG_CK/PWM1/EINTF5)
/RTS: R12.1, U1.8 (PD2/LCD_D4/UART1_CTS/EINTD2)
/SCL: J1.5 (SCL/GPIO3), U1.18 (PD12/LCD_D18/TWI0_SCK/RSB_SCK/EINTD12)
/SDA: J1.3 (SDA/GPIO2), U1.6 (PD0/LCD_D2/TWI0_SDA/RSB_SDA/EINTD0)
/SPDIF: J1.37 (GPIO26), U1.25 (PD17/LCD_D23/OWA_OUT/EINTD17)
/SPI_CLK: J1.23 (SCLK0/GPIO11), U1.40 (PE9/CSI_D6/UART2_RTS/SPI1_CLK/EINTE9)
/SPI_CS: J1.24 (~CE0/GPIO8), U1.42 (PE7/CSI_D4/UART2_TX/SPI1_CS/EINTE7)
/SPI_MISO: J1.21 (MISO0/GPIO9), U1.39 (PE10/CSI_D7/UART2_CTS/SPI1_MISO/EINTE10)
/SPI_MOSI: J1.19 (MOSI0/GPIO10), U1.41 (PE8/CSI_D5/UART2_RX/SPI1_MOSI/EINTE8)
/UART_RX: J1.10 (GPIO15/RXD), U1.49 (PE0/CSI_HSYNC/LCD_D0/TWI2_SCK/UART0_RX/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)
/UART_TX: J1.8 (GPIO14/TXD), U1.48 (PE1/CSI_VSYNC/LCD_D1/TWI2_SDA/UART0_TX/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)
/USB_DN: J4.A7 (D-), J4.B7 (D-), U1.68 (USB-DM)
/USB_DP: J4.A6 (D+), J4.B6 (D+), U1.69 (USB-DP)
/WIFI_DATA_RDY: U1.23 (PD15/LCD_D21/UART2_RTS/TWI2_SCK/EINTD15), U4.18 (GPIO4/ADC1_CH4)
/WIFI_HANDSHAKE: U1.24 (PD16/LCD_D22/UART2_CTS/TWI2_SDA/EINTD16), U4.6 (GPIO3/ADC1_CH3)
/WIFI_SPI_CLK: U1.28 (PD20/LCD_HSYNC/SPI0_CLK/EINTD20), U4.20 (GPIO6)
/WIFI_SPI_CS: U1.26 (PD18/LCD_CLK/SPI0_CS/EINTD18), U4.16 (GPIO10)
/WIFI_SPI_MISO: U1.29 (PD21/LCD_VSYNC/SPI0_MISO/EINTD21), U4.5 (GPIO2/ADC1_CH2)
/WIFI_SPI_MOSI: U1.27 (PD19/LCD_DE/SPI0_MOSI/EINTD19), U4.21 (GPIO7)
GND: C1.2, C2.2, C3.2, C4.2, C6.2, C8.2, C10.2, C11.2, C12.2, C13.2, C14.2, C15.2, C16.2, C17.2, C18.2, C19.2, C20.2, C21.2, C22.2, C23.2, C33.2, C34.2, C35.2, C36.2, C37.2, C38.2, J1.6 (GND), J1.9 (GND), J1.14 (GND), J1.20 (GND), J1.25 (GND), J1.30 (GND), J1.34 (GND), J1.39 (GND), J4.A1 (GND), J4.A8 (SBU1), J4.A12 (GND), J4.B1 (GND), J4.B8 (SBU2), J4.B12 (GND), J4.S1 (SHIELD), Q3.2 (E), R2.2, R4.2, R6.2, R8.2, R16.2, R17.2, SW1.1, SW2.2, SW3.2, U1.74 (TVGND), U1.82 (AGND), U1.89 (EPAD), U3.4 (GND), U3.9 (GND), U4.1 (GND), U4.2 (GND), U4.11 (GND), U4.14 (GND), U4.36 (GND), U4.37 (GND), U4.38 (GND), U4.39 (GND), U4.40 (GND), U4.41 (GND), U4.42 (GND), U4.43 (GND), U4.44 (GND), U4.45 (GND), U4.46 (GND), U4.47 (GND), U4.48 (GND), U4.49 (GND), U4.50 (GND), U4.51 (GND), U4.52 (GND), U4.53 (GND), U6.1 (GND3), U6.4 (GND2), U6.5 (GND2), U6.12 (GND1), U6.13 (GND1), U6.15 (AGND), U6.17 (AGND), U6.21 (EP), Y1.4
unnamed: C5.1, C6.1, L1.2, R1.1, R20.1
unnamed: C7.1, C8.1, L2.2, R3.1, R21.1
unnamed: C9.1, C10.1, L3.2, R5.1, R22.2
unnamed: D1.1 (K), R18.2
unnamed: J4.A5 (CC1), R16.1
unnamed: J4.B5 (CC2), R17.1
unnamed: Q1.1 (B), R15.2
unnamed: Q1.3 (C), R11.2, R14.1
unnamed: Q2.1 (B), R14.2
unnamed: Q2.2 (E), R12.2, R15.1
unnamed: Q3.3 (C), R18.1
unnamed: C23.1, U1.51 (HOSCI), Y1.1
unnamed: C22.1, U1.52 (HOSCO), Y1.3
unnamed: U1.59 (PC0/SPI0_CLK/SDC1_CLK), U3.6 (SCLK)
unnamed: R10.2, U1.60 (PC1/SPI0_CS/SDC1_CMD), U3.1 (~CS)
unnamed: U1.61 (PC2/SPI0_MISO/SDC1_D0), U3.2 (SO/SIO1)
unnamed: U1.62 (PC3/SPI0_MOSI/UART0_TX), U3.5 (SI/SIO0)
unnamed: R9.2, SW1.2, U1.70 (~RESET)
unnamed: R7.2, R8.1, U1.33 (SVREF)
unnamed: C5.2, R1.2, R2.1, U6.14 (FB1)
unnamed: C7.2, R3.2, R4.1, U6.3 (FB2)
unnamed: C9.2, R5.2, R6.1, U6.2 (FB3)
unnamed: L1.1, U6.11 (LX1)
unnamed: L2.1, U6.6 (LX2)
unnamed: L3.1, U6.20 (LX3)

Notes on the sheet:
Vout = 0.6 x R1 / R2 + 0.6

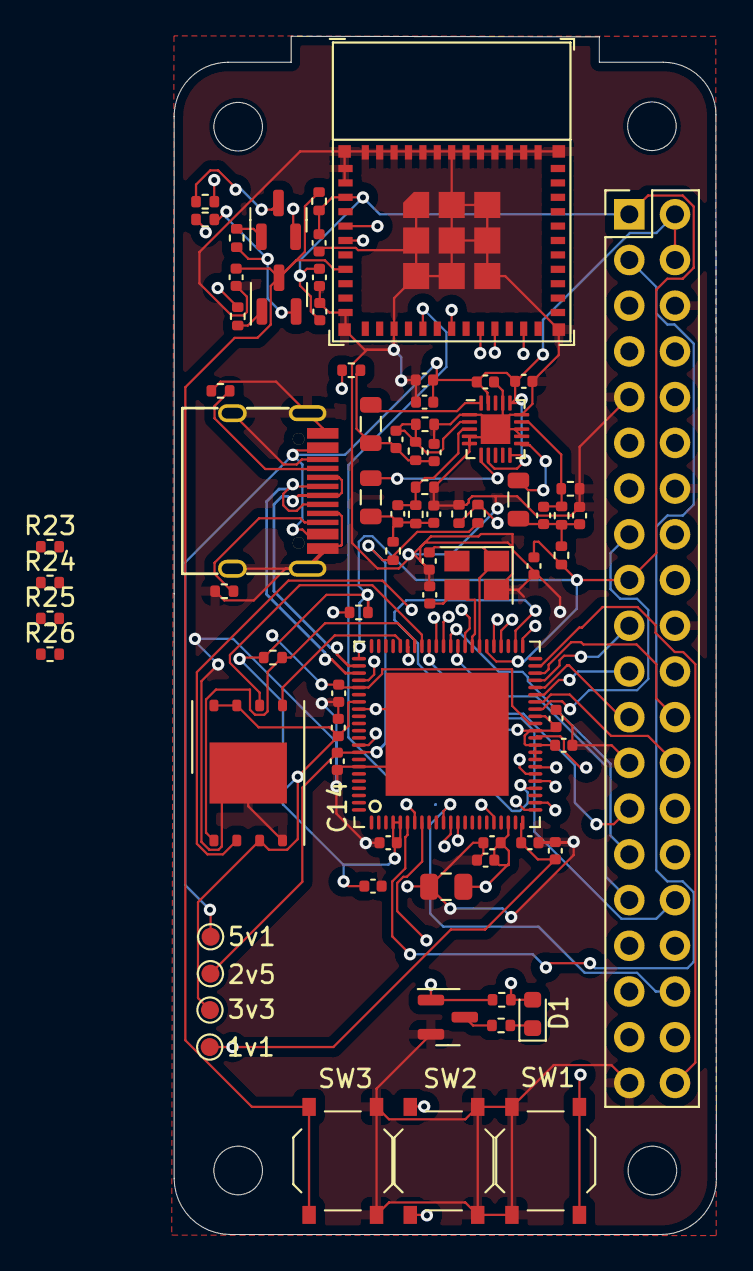
[picture p11: board network_player.kicad_pcb from above]

Board: 4 copper layers, 30.1 x 66.6 mm, 80 parts (0 on the bottom side), 74 nets.
