naguirre/mds-builder/(commit log)

2026-05-27 doc: merge mds-hardware artifacts into Zola doc
    Move v1/v1.1/v2 hardware artifacts to doc/static/hardware/, merge KiCad
    page into hardware/design.md with version table, replace architecture
    ASCII art with a Mermaid diagram, and fix highlight_code config for
    Zola 0.22.
2026-05-27 build: re-pin esp-hosted via tracked overrides.mk and drop unused submodules
2026-05-31 build: bump uboot to 2026.04 and switch kernel to custom linux-sunxi git tree
2026-05-31 docs(hardware): add photos of assembled v1.0 and v1.1 boards
