naguirre/mds-builder/(notices)

Notices in the files:
mds-hardware/network_player/network_player.kicad_pcb:
(c) 2024
